Haurum/P5/Rapport/formalia/FutureWork.tex

\chapter{Future work}
\label{chap:FutureWork}
When the robot is at the impact point sent by the Kinect, it would release both of the motors and then drift further in the direction it was heading. The robot drifting should be avoided by making a brake function, making the robot stop at the exact point the Kinect sent.

An improvement to the current build would be to enable the robot to reset its position by returning to its starting position and resetting its heading, this could be done by implementing a function which achieves the described behaviour.

Further improvements would be to acquire new motors and wheels, but this could introduce scheduling problems since positioning is done through motor encoder interrupts, which could occur too often to schedule the tasks, if the motors are too fast.
This is one of the problems of a cyclic executive, it is a very rigid construct which breaks if any of its scheduled tasks change, or new tasks are introduced.

The delimitations introduced In \ref{sec:Delimitations} could with further improvements be removed. The delimitation of multiple object tracking could be removed, by tracking all objects with the kinect sensor and sending information about all objects landing positions, but also the time in which they would get there. The robot then has to calculate the route it should take to catch all objects and which to skip if impossible to reach everything. The delimitation of not driving backwards could be solved by using motors that can turn around their own axis such that the robot always drives forward and doesn’t need to turn around itself but rather just turn the wheels in the desired direction and go.

Another improvement would be testing the system for stack overflow, which wasn't tested, even though some of the theoretical aspects of it were discussed in \ref{sec:Stack Overflow}, and also  having the experience of using such tools.

If we were to introduce more real-time scheduling theories, the next step would be to implement graceful degradation for the wifi code. This would create the possibility of receiving data continuously, but the wifi code may not be scheduled to receive the data, if there is not enough time for the other tasks to execute. This is a possibility since it would only reduce accuracy of the prediction, since more data from the Kinect sensor leads to more precise prediction of the impact point. This would still introduce the problem of dual-shield compatibility, since the Wifi and Motor Shield cannot operate at the same time, due to them using the same pins.

The fact that both shields cannot operate at the same time could be eliminated by rerouting the pins on the Wifi Shield, or using a cable to send the data, instead of having a wireless connection. With a cable instead of the wireless connection would also reduce the time used on sending the data, but also reduces the mobility of the robot.
