Haurum/P5/Rapport/formalia/forside.tex

	\thispagestyle{empty}
\begin{flushright}
\vspace{3cm}

\phantom{hul}

\phantom{hul}

\phantom{hul}

\textsl{\Huge Dumpsty} \\ \vspace{1cm}

\rule{13cm}{3mm} \\ \vspace{1.5cm}
\vspace{1cm}

%\includegraphics[width=0.9\textwidth]{}

\vspace{7cm} 
\textsc{\Large P5 Project \\
Group SW510E16 \\
Software\\
Aalborg University\\
21st Dec 2016\\}
\end{flushright}
