Haurum/P5/Rapport/formalia/titelblad.tex

% Dette er LaTeX-versionen af titelbladet for TNB studenterrapporter
% Filen kræver:
% Universitetets logo:  AAU-logo-stud-UK eller AAU-logo-stud-DK
% Synopsis: En fil ved navn synopsis.tex

% Udarbejdet af: Jesper Nørgaard (jesper@noergaard.eu) 10. april 2012

\phantomsection
\pdfbookmark[0]{Titelblad}{titelblad}
\thispagestyle{empty}

\begin{minipage}[t]{0.48\textwidth}
\vspace*{-25pt}			%\vspace*{-9pt}

\end{minipage}
\hfill
\begin{minipage}[t]{0.48\textwidth}
{\small 
\textbf{Fifth semester at}\\
\textbf{Department of Computer Science}  \\
Software \\
Selma Lagerlöfs Vej 300 \\
9220 Aalborg East, DK \\
http://www.cs.aau.dk/}
\end{minipage}

\vspace*{1cm}

\begin{minipage}[t]{0.48\textwidth}
\textbf{Title:} \\[5pt]\bigskip\hspace{2ex}
Dumpsty

\textbf{Project:} \\[5pt]\bigskip\hspace{2ex}
P5-project

\textbf{Project period:} \\[5pt]\bigskip\hspace{2ex}
September 2016 - December 2016

\textbf{Project group:} \\[5pt]\bigskip\hspace{2ex}
SW510E16	

\textbf{Participants:} \\[5pt]\hspace*{2ex}
Christian Dannesboe \\\hspace*{2ex}
Frederik Børsting Lund \\\hspace*{2ex}
Karrar Al-Sami \\\hspace*{2ex}
Mark Kloch Haurum \\\hspace*{2ex}
Lasse Lyngø Nielsen \\\hspace*{2ex}
Søren Lyng \\\hspace*{2ex}

\textbf{Supervisor:} \\[5pt]\hspace*{2ex}
Bent Thomsen

\vspace*{1cm}

\textbf{Pagecount: \pageref{LastPage}} \\
\textbf{Appendix range: 26} \\ 
\textbf{Published 21-12-2016}

\end{minipage}
\hfill
\begin{minipage}[t]{0.483\textwidth}
Synopsis: \\[5pt]
\fbox{\parbox{7cm}{\bigskip\input{formalia/synopsis}\bigskip}}
\end{minipage}

\vfill

{\footnotesize\itshape The content of the article is freely available, but may only be published with reference to the article.}

% Rapportens indhold er frit tilgængeligt, men offentliggørelse (med kildeangivelse) må kun ske efter aftale med forfatterne.
% The content of the report is freely available, but publication (with source reference) may only take place in agreement with the authors.
