Haurum/P5/Rapport/kontekst/DesignSpecification.tex

\chapter{Design specification}
\label{chap:Design specification}
This chapter will present the requirements and the way they are conducted for the project, the requirements will be examined at the end of the report to see if they are fulfilled. The last section in the chapter will describe the delimitations made for the project.

\section{System requirements}
\label{sec:System requirements}
The requirements for the project is assembled throughout several chapters. The analysis chapter \ref{chap:Analysis}, is were the most of the requirements are conducted. The general requirements are extracted from the user story in section \ref{sec:User story}. In the Hardware section \ref{sec:Hardware}, the hardware sets limitations for the project which lead to more detailed requirements in the form of sub-requirements.

While working on the robot, problems has occurred and the requirements therefore change. The changes done to the requirements during the project, can be seen in the increments found in the appendixes \ref{chap:Increment one}, \ref{chap:Increment two} and \ref{chap:Increment three}, where the requirements for the project are in the evaluation section \ref{sec:i3Evaluation}, in appendix \ref{chap:Increment three}.

The requirements for the project are established throughout the whole process and changes are made accordingly, to adapt to the hardware's limitations and the problems found. The requirements are listed below: 

\begin{itemize}
	\item The trash bin should catch the object if the user throws it towards the trash bin and within a predefined area
	\begin{itemize}
		\item {The robots predefined area should be calculated from the hardware limitations of the motors’ speed}
	\end{itemize}
	\item The robot should know where it is positioned
	\begin{itemize}
		\item {The robot should have a starting position, from where it should be able to calculate it's current position through calculations of the motor encoders}
		\item {The robot's starting point should be placed outside its predefined area, such that it moves forward into the area}
	\end{itemize}
	\item The robot should be able to detect and track the thrown object
	\begin{itemize}
		\item {The thrown object should be detected and tracked by a Microsoft Kinect}
		\item {The Kinect should send the coordinates of the impact point of the trash to the robot}
	\end{itemize}
	\item The robot should be able to calculate the impact point for the object
	\begin{itemize}
		\item {Trajectory prediction should be used to calculate impact point of the thrown object}
	\end{itemize}
	\item The robot should be able to move the trash bin, such that the thrown object lands inside the bin
	\begin{itemize}
		\item {The robot should be able to turn and drive forward}
		\item{The robot should be able to recognize the coordinates sent from the Kinect}
	\end{itemize}
	\item {The robot should be able to receive data from a computer, through a wireless network}
	\item {The system tasks should be able to be scheduled and verified}
\end{itemize}

\section{Delimitations}
\label{sec:Delimitations}
It has been decided that for simplicity, only one object will be thrown at any given time. This delimits any multiple object tracking and prediction. \newline
It has also been decided that the robot should not drive backwards. The robot starts on the edge of its predefined area and will only drive forward into the area. This means that if the robot is already heading towards a point in its predefined area, and the Kinect sends a new point, which is behind the robot, it has to turn 180 deg to drive to the new point given by the Kinect.
