Haurum/P5/(commit log)

2016-10-10 LEGO NXT Servo Motor
    NXT Motor hardware documentation
2016-10-24 arduino stuff
2016-10-26 Gyro scope + accelerometer
2016-10-26 arduino trololol
2016-10-31 Gyoscope and Accelerometer, increment one 2. and 3. requirements evaluation.
2016-11-06 Gyro and a-meter
2016-11-13 indledninger til de forskellige chapters og sections tilføjet
2016-11-15 Motory
    Motory to Motor conversion
2016-11-16 Some arduino shit
2016-11-17 Arduino program desgin
2016-11-21 Arduino Wifi og Kinect connection (system design)
2016-11-22 Subsection: Arduino IDE
2016-11-30 Cyclic executive og interrupt def og problemer
2016-12-05 Hello Deer
    Kinect i System Design, tool-chain opstillet.
2016-12-06 tool-chain
    short
2016-12-07 Roughly finish'd systemdesign real-time/interrupts
2016-12-08 Something about jitter
2016-12-12 Arduino code
2016-12-15 Connecting Arduino and Kinect
